opentrv/OpenTRV-TRV1.6/README.md

# OpenTRV-TRV1.6
TRV1.6 smart thermostatic radiator valve hardware and software,
evolved from TRV1.5/REV7.

A 'V0p2' type (ATmega328P) board with an alternative motor driver.
