opentrv/OpenTRV-TRV1.6/hardware/PCB/board.png

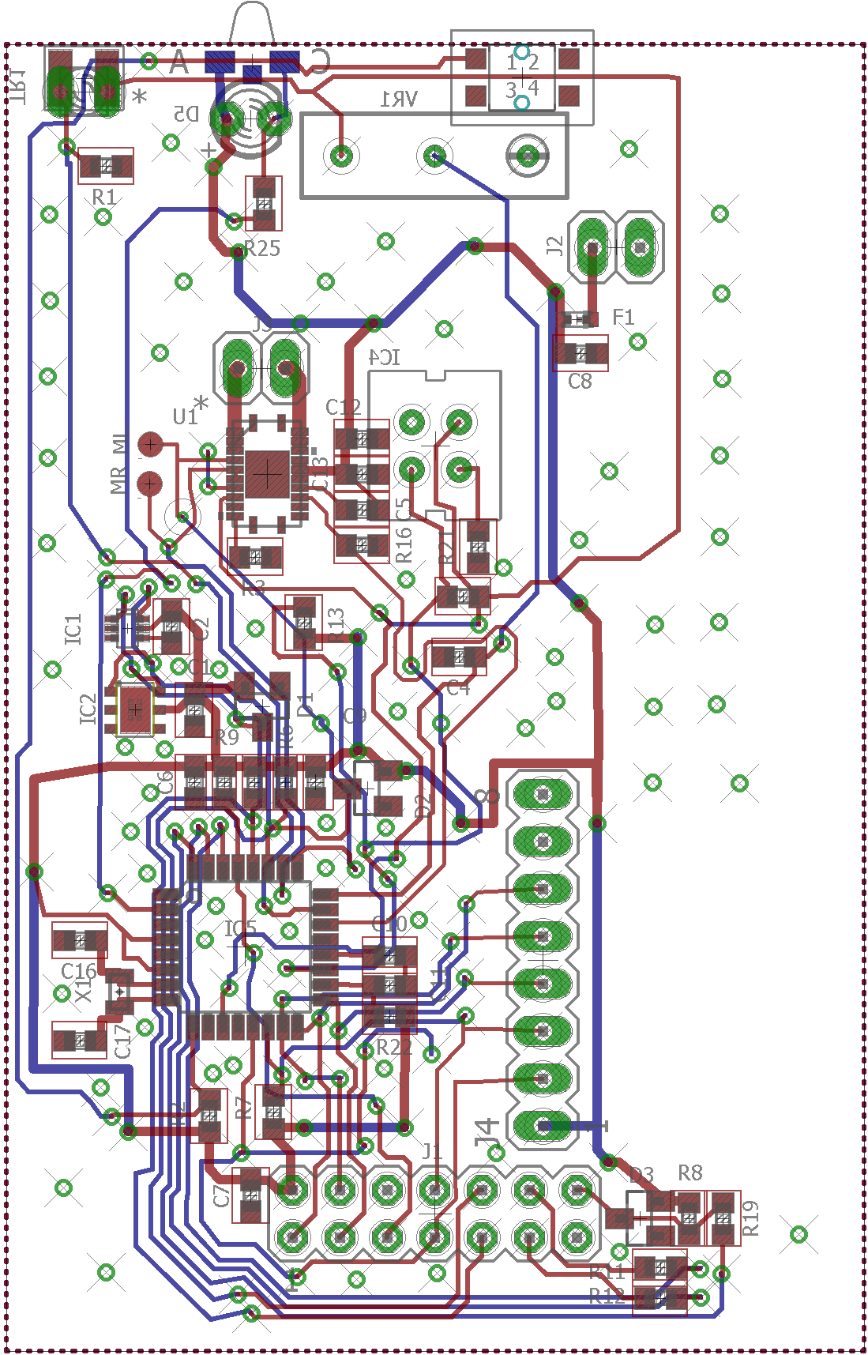
hardware/PCB/board.png
