opentrv/OpenTRV-TRV1.6/hardware/PCB/schematic.png

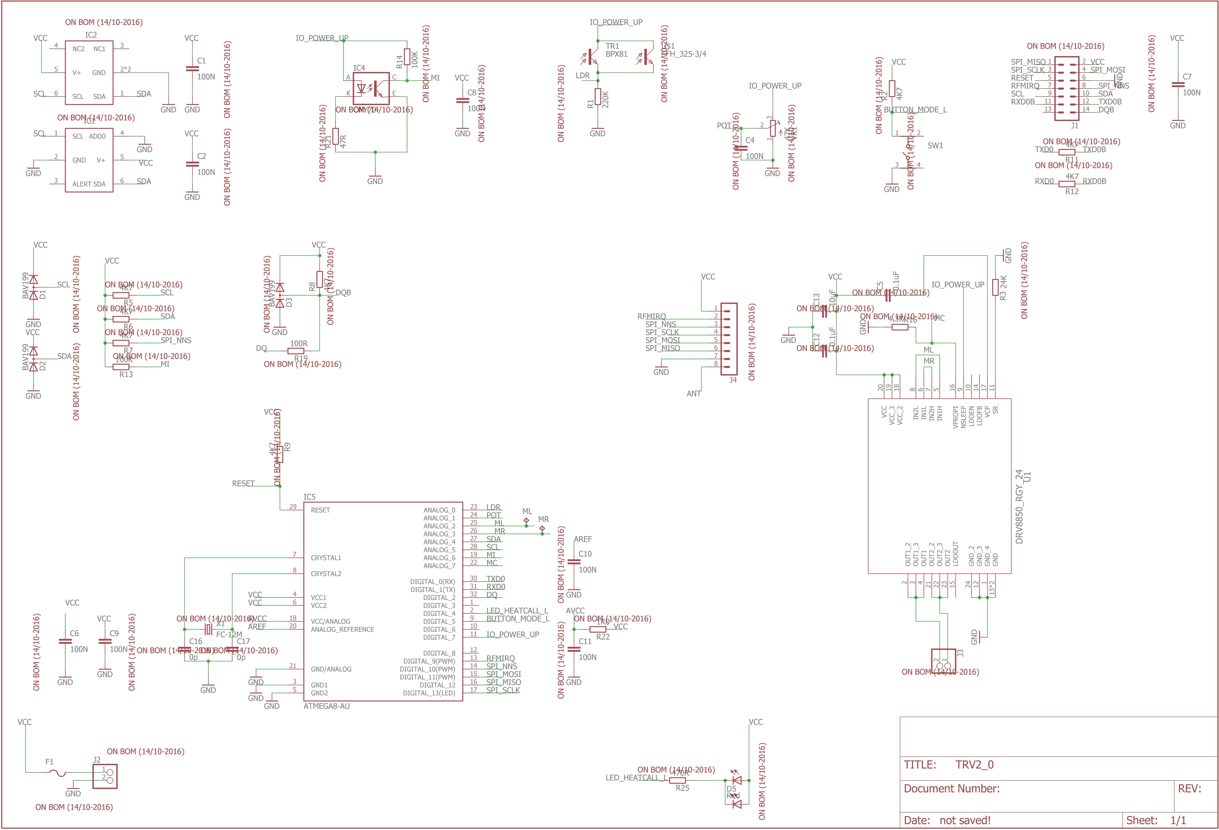
hardware/PCB/schematic.png
