opentrv/OpenTRV-TRV1.6/hardware/PCB/201610 DRAFT TRV2 BOM.ods

Sheet: Sheet3
Note | Legend | Part Type | Description | MFG | MFG Code | Supplier | Supplier Code | TYPE | Part Count | £'s Each | Total £'s
 | F1 | F.1A CHIP FUSE SMT | 1 Amp 63V | RS | CQ06PT001 | RS Components | 764-9431 | SMD | 1 | 0.08 | 0.08
C2 decoupling for TMP112, C1 decoupling for SHT21 | C1, C2, C8, C4, C7, C6, C9, C10, C11 | C0603.100N | CAP MULTILYR CHIP 100N 10% 50V X7R 0603 | AVX | 06035C104KAZ2A | RS Components | 698-3263 | SMD | 9 | 0.07 | 0.64
DO NOT FIT - In a Pack of 4000 | C16, C17 | C0603.22P | CAP MULTILYR CHIP 22P 5% 50V NPO 0603 | Phycomp | 223886715229 | RS Components | 616-9133 | SMD | 0 | 0.01 | 0.00
 | C13 | 10uF | CAP MULTILYR CHIP 10uF 5% 50V NPO 0603 | Murata | GRM188R61A106KE69D | RS Components | 846-7293 | SMD | 1 | 0.04 | 0.04
 | C12, C5 | 0.1uF | CAP MULTILYR CHIP 0.1uF 5% 50V NPO 0603 | AVX | 0603YC104JAT2A | RS Components | 391-246 | SMD | 2 | 0.00 | 0.01
IF SMD take the one below | D5 | D.3MM.RED.LED | 3mm Red LED | Kingbright | L-1154ID | RS Components | 862-2737 | LEADED | 0 | 0.05 | 0.00
 | U$2 |  | SideLED Red SMD LED | Kingbright | KPPA-3010SURCK | Farnell | 2449732 | SMD | 1 | 0.17 | 0.17
Reels of 3000 - Temporarily out of stock - Back order for despatch 09/11/2016 | D3, D1, D2 | D.BAV99 | DIODE SM_SIG EPI 200MA 70V 6NS DUAL SOT23 | FAIRCHILD SEMICONDUCTOR | BAV99 | RS Components | 545-2686 | SMD | 3 | 0.01 | 0.03
 | IC5 | IC.ATMEGA328P-AU | IC ATMEL MEGA 328P PROCESSOR 8-BIT RISC TQFP | ATMEL | ATMEGA328P-AU | RS Components | 696-3092 | SMD | 1 | 2.27 | 2.27
 | IC4 | IC.CNY70 | CNY70 Through Hole Reflective Optical Sensor Phototransistor Output | Vishay | CNY70 | RS Components | 708-5348 | LEADED | 1 | 0.61 | 0.61
DO NOT FIT - Default is TMP112 | IC2 | IC.SHT21 | Sensor Humidity & Temp 2%RH I2C | Sensirion | SHT21 | RS Components | 786-5554 | SMD | 1 | 3.32 | 3.32
 | IC1 | IC.TMP112AIDRLR | High-Accuracy Low-Power Digital Temperature Sensor | TI | TMP112AIDRLR | RS Components | 709-8868 | SMD | 0 | 1.79 | 0.00
 |  | DRV8850 | Motor driver chip
IF SMD take the one below | TR1 | O.3MM PHOTO TRANSISTOR | 3mm Photo Transistor | KingBright | L-323PC | Rapid Electronics | 58-0105 | LEADED | 0 | 0.23 | 0.00
 | U$1 |  | Sideview phototransistor | OSRAM Opto Semiconductors | SFH 325-3/4 | RS Components | 654-8003 | SMD | 1 | 0.12 | 0.12
 | VR1 | R.POT47K | 16mm Rotary pot 47K lin right angle | ISKRA | P11M47AP6L45R | JPR Electronics | 551-140 | LEADED | 1 | 0.49 | 0.49
 | R14, R13 | R0603.100K | RES THICKFLM CHIP 100K 1% 0W1 100ppm 0603 | Bourns | CR0603-FX-1003ELF | RS Components | 740-8802 | SMD | 2 | 0.01 | 0.02
 | R19 | R0603.100R | RES THICKFLM CHIP 100R 1% 0W1 100ppm 0603 | Bourns | CR0603-FX-1000ELF | RS Components | 740-8798 | SMD | 1 | 0.01 | 0.01
Reels of 5,000 | R22 | R0603.1R0 | RES THICKFLM CHIP 1R0 1% 0W1 100ppm 0603 | RS Pro | RS-0603-1R-1%-0.1W | RS Components | 716-9752 | SMD | 1 | 0.00 | 0.00
 | R1 | R0603.220K | RES THICKFLM CHIP 220K 1% 0W1 100ppm 0603 | TE Connectivity | CRG0603F220K | RS Components | 213-2581 | SMD | 1 | 0.01 | 0.01
 | R25 | R0603.470R | RES THICKFLM CHIP 470R 1% 0W1 100ppm 0603 | Vishay | CRCW0603470RFKEA | RS Components | 679-0419 | SMD | 1 | 0.01 | 0.01
 | R21 | R0603.47R | RES THICKFLM CHIP 47R 1% 0W1 100ppm 0603 | Vishay | CRCW060347R0FKEA | RS Components | 679-0437 | SMD | 1 | 0.01 | 0.01
 | R2, R11, R12, R8, R5, R6, R7, R9 | R0603.4K7 | RES THICKFLM CHIP 4K7 1% 0W1 100ppm 0603 | Bourns | CR0603-FX-4701ELF | RS Components | 740-8877 | SMD | 8 | 0.01 | 0.10
 | R16 | 4K3 | RES THICKFLM CHIP 4K3 1% 0W1 100ppm 0603 | Vishay | CRCW06034K30FKEA | RS Components | 679-0469 | SMD | 1 | 0.01 | 0.01
 | R3 | 24K | RES THICKFLM CHIP 24K 1% 0W1 100ppm 0603 | Vishay | CRCW060324K0FKEA | RS Components | 679-0046 | SMD | 1 | 0.01 | 0.01
 | SW1 | SW.TACTILE SWITCH RA | Push button SMD | Wurth Elektronik | 436333045822 | RS Components | 785-6453 | SMD | 1 | 0.35 | 0.35
 | X1 | X.32.7689KHZ SMT 2 PIN | QTC3 Series 1.5x3.2 SMD Tuning Fork 12.5pf | QANTEK | QTC332.76812B2R | RS Components | 814-9352 | SMD | 1 | 0.45 | 0.45
 | J1 | J.14WAY HEADER RA | .54 mm Pitch 14 Way 2 Row Right Angle PCB Header | Wurth Elektronik | 61301421021 | RS Components | 828-1715 | LEADED | 1 | 0.72 | 0.72
 | J2, J3 | HEADER 2 WAY | 2 pin header. 0.254mm | Molex | 22-23-2021 | RS Components | 679-5583 | LEADED | 2 | 0.06 | 0.12
For optional RFM or other radio module | J4 | HEADER 8 WAY | 8 pin header. 0.254mm |  |  |  |  | LEADED | 0 |  | 0.00
 |  |  |  |  |  |  |  |  |  |  | 10

Sheet: BOM
Note | Legend | Part Type | Description | MFG | MFG Code | Supplier | Supplier Code | TYPE | Part Count | £'s Each | Total £'s
C19, C20, C21, C22 skipped as it was motor driver related | C19, C20, C21, C22 | C.100UF/6.3V | 100000 nF ±20 % 6.3 V X5R Dielectric | Samsung Electro-Mechanics | CL31A107MQHNNNE | RS Components | 766-1078 | LEADED | 4 | 227 | 908
 | C18 | C.ATANT 10U 6V | CAP TANT 10µ 20% 6V -55/+125C SM | EPCOS |  | RS Components | 538-2363 | SMD | 1 | 172 | 1,721
C13 skipped as it was motor driver related | C1, C2, C3, C4, C8, C9, C10, C11, C12, C5, C6, C7 | C0603.100N | CAP MULTILYR CHIP 100N 10% 50V X7R 0603 | Murata | GRM188R71H104KA93D | RS Components | 545-9895 | SMD | 15 | 0,07 | 1,05
NOT FOUND on schematic |  | C0603.10N | CAP MULTILYR CHIP 10N 10% 50V X7R 0603 | Phycomp | CC0603KRX7R9BB103 | JPR Electronics | 133-846 | SMD | 4 | 247 | 988
DO NOT FIT | C16, C17 | C0603.22P | CAP MULTILYR CHIP 22P 5% 50V NPO 0603 | Phycomp | 223886715229 | RS Components | 616-9133 | SMD | 2 | 4 | 8
REMOVED | D4 | D.3MM.GREEN.LED | 3mm GREEN LED |  |  | Rapid Electronics | 55-1670 | LEADED | 1 | 0,28 | 0,28
 | D5 | D.3MM.RED.LED | 3mm Red LED |  |  | Rapid Electronics | 72-8942 | LEADED | 1 | 0,1 | 0,1
 | D3, D1, D2 | D.BAV99 | DIODE SM_SIG EPI 200MA 70V 6NS DUAL SOT23 | FAIRCHILD SEMICONDUCTOR | BAV99 | RS Components Contract | 545-2686 | SMD | 3 | 225 | 675
D6a, D6b skipped as it was motor driver related | D6a, D6b | D.SDA004 | DATA BUS TRANSIENT SUPPRESSOR | DiodesZetex | SDA004-7 | RS Components | 751-4938 | SMD | 1 | 0,4 | 0,4
 | F1 | F.1A CHIP FUSE SMT | 1 Amp 63V | RS | CQ06PT001 | RS Components | 764-9431 | SMD | 1 | 154 | 154
NOT FOUND on schematic |  | HEADER 1 WAY | 1 pin header. 0.254mm |  |  | SIL | 0 | LEADED | 5 | 1 | 5
 | J2, J4 | HEADER 2 WAY | 2 pin header. 0.254mm | Harwin |  | JPR Electronics | 710-622 | LEADED | 2 | 23 | 46
 | IC3 | IC.APDS-9300 | Ambient light sensor digital I2C SMT | Avago Technologies | APDS-9300-020 | RS Components | 691-0470 | SMD | 1 | 0,64 | 0,64
 | IC5 | IC.ATMEGA328P-AU | IC ATMEL MEGA 328P PROCESSOR 8-BIT RISC TQFP | ATMEL | ATMEGA328P-AU | RS Components | 696-3092 | SMD | 1 | 2,28 | 22,801
 | IC4 | IC.CNY70 | CNY70 Through Hole Reflective Optical Sensor Phototransistor Output | Vishay | CNY70 | RS Components | 708-5348 | SMD | 1 | 566 | 5,661
 | IC2 | IC.SHT21 | Sensor Humidity & Temp 2%RH I2C | Sensirion | SHT21 | RS Components | 786-5554 | SMD | 1 | 2,91 | 2,91
 | IC1 | IC.TMP112AIDRLR | High-Accuracy Low-Power Digital Temperature Sensor | TI | TMP112AIDRLR | RS Components | 709-8868 | SMD | 1 | 1,7 | 1,7
IC6 skipped as it was motor driver related | IC6 | IC.TS1003IG5T | Operational Amplifier Precision 4 kHz R-R 0.8 - 5.5 V | Touchstone Semiconductor | TS1003IG5T | RS Components | 787-8080 | SMD | 1 | 551 | 551
 | J1 | J.14WAY HEADER RA | .54 mm Pitch 14 Way 2 Row Right Angle PCB Header | Samtec | TSW-107-08-L-D-RA | RS Components | 767-0968 | LEADED | 1 | 1,25 | 1,25
L1 skipped as it was motor driver related | L1 | L..1.2UH SMD | 1.2uH inductor | Wurth Electronic | 74438313012 | RS Components | 792-2711 | SMD | 3 | 1,08 | 3,24
 | MD1 | MD.RFM23B | RFM23B ISM TRANSCEIVER MODULE | HOPERF | RFM23B-S | RS Components | 762-0103 | SMD | 1 | 5,8 | 5,8
 | - | MTFLR-001-SSL | PCB FR4 2 Layer PTH |  |  | ONE Way | MTFLR-001-SSL | PCB | 1 | 1 | 1
 | TR1 | O.3MM PHOTO TRANSISTOR | 3mm Photo Transistor | KingBright | L-323PC | Rapid Electronics | 58-0105 | LEADED | 1 | 0,12 | 0,12
 | - | OTRVRV-002-SIL | PCB FR4 2 Layer PTH |  |  | ONE Way | OTRVRV-002-SIL | PCB | 1 | 0,5 | 0,5
 | VR1 | R.POT47K | 16mm Rotary pot 47K lin right angle | ISKRA | P11M47AP6L45R | JPR Electronics | 551-140 | LEADED | 1 | 0,49 | 0,49
R15, R16, R17 skipped as it was motor driver related | R14, R13 | R0603.100K | RES THICKFLM CHIP 100K 1% 0W063 50V 100ppm 0603 | WELWYN | WCR0603104 1% 100ppm | JPR Electronics | 406-705 | SMD | 6 | 15 | 0,09
R20 skipped as it was motor driver related | R19 | R0603.100R | RES THICKFLM CHIP 100R 1% 0W063 50V 100ppm 0603 | WELWYN | WCR0603101 1% 100ppm | JPR Electronics | 406-634 | SMD | 2 | 25 | 5
R34, R35 skipped as it was motor driver related | R34, R35 | R0603.10K | RES THICKFLM CHIP 10K 1% 0W063 50V 100ppm 0603 | WELWYN | WCR0603103 1% 100ppm | JPR Electronics | 406-682 | SMD | 2 | 15 | 0,03
R38, R37 skipped as it was motor driver related | R38, R37 | R0603.15K | RES THICKFLM CHIP 15K 1% 0W063 50V 100ppm 0603 | WELWYN | WCR0603153 1% 100ppm | JPR Electronics | 406-686 | SMD | 2 | 15 | 3
 | R22, R23 | R0603.1R0 | RES THICKFLM CHIP 1R0 1% 0W063 50V 100ppm 0603 | WELWYN | 1% 100ppm | RS Components | 504-8978 | SMD | 2 | 211 | 43
 | R1 | R0603.220K | RES THICKFLM CHIP 220K 1% 0W063 50V 100ppm 0603 | WELWYN | WCR0603224 1% 100ppm | JPR Electronics | 406-712 | SMD | 1 | 16 | 16
R39 skipped as it was motor driver related | R39 | R0603.330K | RES THICKFLM CHIP 330K 1% 0W063 50V 100ppm 0603 | RS | RS-0603-330k-1%-0.1W | JPR Electronics | 406-716 | SMD | 1 | 16 | 16
R28, R29 skipped as it was motor driver related | R28, R29 | R0603.330R | RES THICKFLM CHIP 330R 1% 0W063 50V 100ppm 0603 | RS |  | RS Components | 617-6434 | SMD | 2 | 8 | 16
R40 skipped as it was motor driver related | R40 | R0603.3M3 | RES THICKFLM CHIP 3M3 1% 0W063 50V 100ppm 0603 | Phycomp |  | RS Components | 504-6540 | SMD | 1 | 22 | 22
R24 Removed. R26, R27 skipped as it was motor driver related | R24, R25 | R0603.470R | RES THICKFLM CHIP 470R 1% 0W063 50V 100ppm 0603 | WELWYN | WCR0603471 1% 100ppm | JPR Electronics | 406-650 | SMD | 4 | 25 | 0,01
 | R21 | R0603.47R | RES THICKFLM CHIP 47R 1% 0W063 50V 100ppm 0603 | WELWYN | WCR0603470 1% 100ppm | RS Components | 617-6658 | SMD | 1 | 8 | 8
R3, R4 Removed | R8, R10, R5, R6, R7, R2, R3, R4, R11, R12, R9 | R0603.4K7 | RES THICKFLM CHIP 4K7 1% 0W063 50V 100ppm 0603 | WELWYN | WCR0603472 1% 100ppm | JPR Electronics | 406-674 | SMD | 11 | 15 | 1,651
R36 skipped as it was motor driver related | R36 | R1206.0R1 | RES THICKFLM CHIP 0R33 1% 0W25 1206 | WELWYN |  | Farnell | 1795287 | SMD | 1 | 68 | 68
R32, R33 skipped as it was motor driver related | R32, R33 | R1206.100R | RES THICKFLM CHIP 100R 1% 0W25 1206 | RS |  | RS Components | 617-6327 | SMD | 2 | 12 | 24
R30, R31 skipped as it was motor driver related | R30, R31 | R1206.470R | RES THICKFLM CHIP 470R 1% 0W25 1206 | WELWYN | WCR1206470R | RS Components | 617-5447 | SMD | 2 | 12 | 24
SW2, SW3 Removed | SW1, SW2, SW3 | SW.TACTILE SWITCH RA | Push button SMD | Wurth Elektronik | 436331045822 | RS Components | 785-6459 | LEADED | 3 | 0,33 | 0,99
TR8, TR9 skipped as it was motor driver related | TR8, TR9 | TR.ZXTN23015 | ZXTN23015CFHTA Bipolar Transistor NPN 6 A 15 V HFE150 235 MHz | DiodesZetex | ZXTN23015CFHTA | RS Components | 751-5423 | SMD | 2 | 0,56 | 1,12
TR2, TR3, TR4, TR5, TR6, TR7 skipped as it was motor driver related | TR2, TR3, TR4, TR5, TR6, TR7 | TRP.ZXTP23015 | ZXTP23015CFHTA Bipolar Transistor PNP -6 A -15 V HFE:140 270Mhz | DiodesZetex | ZXTP23015CFHTA | RS Components | 751-5451 | SMD | 6 | 551 | 3,306
 | X1 | X.32.7689KHZ SMT 2 PIN | QTC3 Series 1.5x3.2 SMD Tuning Fork 12.5pf | QANTEK | QTC332.76812B2R | RS Components | 814-9352 | SMD | 1 | 434 | 434
 |  |  |  |  |  |  |  |  |  |  | 306,394

Sheet: Pick&Place
Placed | Designator | Footprint | Mid X | Mid Y | Ref X | Ref Y | Pad X | Pad Y | Layer | Rotation | Comment
* | F1 | CQ06PT | 1104mil | 2176mil | 1104mil | 2176mil | 1076.047mil | 2176mil | T | 0 | F.1A CHIP FUSE SMT
 | D6 | SOT363 | 597.402mil | 2166.409mil | 560mil | 2192mil | 560mil | 2192mil | T | 360 | D.SDA004
* | MD1 | RFM23B-S1 | 1253.039mil | 747.591mil | 1568mil | 472mil | 1568mil | 472mil | T | 180 | MD.RFM23B
* | J1 | IDC14-HEADER | 804mil | 290mil | 504mil | 240mil | 504mil | 240mil | T | 90 | J.14WAY HEADER RA
* | R9 | SM0603 | 360mil | 1200mil | 360mil | 1200mil | 360mil | 1167.5mil | T | 180 | R0603.4K7
* | R7 | SM0603 | 464mil | 504mil | 464mil | 504mil | 464mil | 471.5mil | T | 180 | R0603.4K7
* | R6 | SM0603 | 488mil | 1200mil | 488mil | 1200mil | 488mil | 1232.5mil | T | 360 | R0603.4K7
* | R23 | SM0603 | 1224mil | 1112mil | 1224mil | 1112mil | 1191.5mil | 1112mil | T | 90 | R0603.1R0
* | R22 | SM0603 | 709.221mil | 706.74mil | 709.221mil | 706.74mil | 676.721mil | 706.74mil | T | 90 | R0603.1R0
* | R5 | SM0603 | 424mil | 1200mil | 424mil | 1200mil | 424mil | 1232.5mil | T | 360 | R0603.4K7
* | R12 | SM0603 | 1280mil | 112mil | 1280mil | 112mil | 1312.5mil | 112mil | T | 270 | R0603.4K7
* | IC5 | Quad32 | 404.079mil | 852.323mil | 228.882mil | 962.559mil | 228.882mil | 962.559mil | T | 360 | IC.ATMEGA328P-AU
* | C1 | SM0603 | 296mil | 1352mil | 296mil | 1352mil | 296mil | 1384.5mil | T | 360 | C0603.100N
* | C3 | SM0603 | 440mil | 2552mil | 440mil | 2552mil | 472.5mil | 2552mil | T | 270 | C0603.100N
* | C2 | SM0603 | 248mil | 1528mil | 248mil | 1528mil | 248mil | 1560.5mil | T | 360 | C0603.100N
* | C4 | SM0603 | 856mil | 1464mil | 856mil | 1464mil | 888.5mil | 1464mil | T | 270 | C0603.100N
* | C5 | SM0603 | 920mil | 1152mil | 920mil | 1152mil | 920mil | 1119.5mil | T | 180 | C0603.100N
* | C8 | SM0603 | 1112mil | 2104mil | 1112mil | 2104mil | 1079.5mil | 2104mil | T | 90 | C0603.100N
* | C9 | SM0603 | 552mil | 1200mil | 552mil | 1200mil | 552mil | 1232.5mil | T | 360 | C0603.100N
* | C10 | SM0603 | 709.221mil | 834.74mil | 709.221mil | 834.74mil | 741.721mil | 834.74mil | T | 270 | C0603.100N
* | C11 | SM0603 | 709.221mil | 770.74mil | 709.221mil | 770.74mil | 676.721mil | 770.74mil | T | 90 | C0603.100N
* | C7 | SM0603 | 416mil | 328mil | 416mil | 328mil | 416mil | 360.5mil | T | 360 | C0603.100N
* | C6 | SM0603 | 296mil | 1200mil | 296mil | 1200mil | 296mil | 1232.5mil | T | 360 | C0603.100N
* | C12 | SM0603 | 1648mil | 752mil | 1648mil | 752mil | 1648mil | 784.5mil | T | 360 | C0603.100N
 | C13 | SM0603 | 1007.488mil | 1709.441mil | 1007.488mil | 1709.441mil | 974.988mil | 1709.441mil | T | 90 | C0603.100N
 | C14 | SM0603 | 456mil | 1792mil | 456mil | 1792mil | 488.5mil | 1792mil | T | 270 | C0603.100N
 | C15 | SM0603 | 608mil | 1688mil | 608mil | 1688mil | 608mil | 1655.5mil | T | 180 | C0603.100N
* | C16 | SM0603 | 103.599mil | 880.378mil | 103.599mil | 880.378mil | 103.599mil | 847.878mil | T | 180 | C0603.22P
* | C17 | SM0603 | 152mil | 624mil | 152mil | 624mil | 119.5mil | 624mil | T | 90 | C0603.22P
* | C18 | TANTA | 1391.5mil | 1112mil | 1344mil | 1112mil | 1344mil | 1112mil | T | 360 | C.ATANT 10U 6V
 | C19 | SM1206 | 990.85mil | 2331.528mil | 990.85mil | 2331.528mil | 990.85mil | 2276.528mil | T | 180 | C.100UF/6.3V
 | C20 | SM1206 | 1161.48mil | 2007.968mil | 1161.48mil | 2007.968mil | 1106.48mil | 2007.968mil | T | 90 | C.100UF/6.3V
 | C21 | SM1206 | 1161.48mil | 1903.968mil | 1161.48mil | 1903.968mil | 1106.48mil | 1903.968mil | T | 90 | C.100UF/6.3V
 | C22 | SM1206 | 1161.48mil | 1799.968mil | 1161.48mil | 1799.968mil | 1106.48mil | 1799.968mil | T | 90 | C.100UF/6.3V
* | D1 | SOT23 | 440mil | 1360mil | 440mil | 1360mil | 477.5mil | 1400mil | T | 270 | D.BAV99
* | D2 | SOT23 | 661.221mil | 1186.74mil | 661.221mil | 1186.74mil | 701.221mil | 1149.24mil | T | 180 | D.BAV99
* | D3 | SOT23 | 1224mil | 280mil | 1224mil | 280mil | 1264mil | 242.5mil | T | 180 | D.BAV99
* | IC1 | SOT563(6PIN) | 154.575mil | 1524.315mil | 128mil | 1544mil | 128mil | 1544mil | T | 360 | IC.TMP112AIDRLR
* | R1 | SM0603 | 160mil | 2512mil | 160mil | 2512mil | 192.5mil | 2512mil | T | 270 | R0603.220K
 | R15 | SM0603 | 177mil | 1941.945mil | 177mil | 1941.945mil | 144.5mil | 1941.945mil | T | 90 | R0603.100K
 | R16 | SM0603 | 864mil | 2048mil | 864mil | 2048mil | 831.5mil | 2048mil | T | 90 | R0603.100K
 | R17 | SM0603 | 224mil | 2320mil | 224mil | 2320mil | 191.5mil | 2320mil | T | 90 | R0603.100K
 | R18 | SM0603 | 176mil | 2080mil | 176mil | 2080mil | 176mil | 2112.5mil | T | 360 | R0603.100K
* | R8 | SM0603 | 1328mil | 280mil | 1328mil | 280mil | 1328mil | 247.5mil | T | 180 | R0603.4K7
* | R2 | SM0603 | 328mil | 496mil | 328mil | 496mil | 328mil | 528.5mil | T | 360 | R0603.4K7
* | R3 | SM0603 | 352mil | 328mil | 352mil | 328mil | 352mil | 295.5mil | T | 180 | R0603.4K7
* | R4 | SM0603 | 144mil | 1200mil | 144mil | 1200mil | 144mil | 1167.5mil | T | 180 | R0603.4K7
* | R10 | SM0603 | 400mil | 504mil | 400mil | 504mil | 400mil | 536.5mil | T | 360 | R0603.4K7
* | R11 | SM0603 | 1280mil | 176mil | 1280mil | 176mil | 1312.5mil | 176mil | T | 270 | R0603.4K7
 | R20 | SM0603 | 592mil | 1536mil | 592mil | 1536mil | 592mil | 1568.5mil | T | 360 | R0603.100R
* | R13 | SM0603 | 528mil | 1536mil | 528mil | 1536mil | 528mil | 1503.5mil | T | 180 | R0603.100K
* | R14 | SM0603 | 864mil | 1592mil | 864mil | 1592mil | 831.5mil | 1592mil | T | 90 | R0603.100K
 | R34 | SM0603 | 688mil | 2000mil | 688mil | 2000mil | 720.5mil | 2000mil | T | 270 | R0603.10K
 | R35 | SM0603 | 328mil | 2128mil | 328mil | 2128mil | 328mil | 2095.5mil | T | 180 | R0603.10K
* | R19 | SM0603 | 1400mil | 280mil | 1400mil | 280mil | 1400mil | 247.5mil | T | 180 | R0603.100R
* | R21 | SM0603 | 896mil | 1696mil | 896mil | 1696mil | 896mil | 1663.5mil | T | 180 | R0603.47R
* | R24 | SM0603 | 1344mil | 2504mil | 1344mil | 2504mil | 1344mil | 2471.5mil | T | 180 | R0603.470R
* | R25 | SM0603 | 544mil | 2520mil | 544mil | 2520mil | 544mil | 2487.5mil | T | 180 | R0603.470R
 | R26 | SM0603 | 145mil | 1837.945mil | 145mil | 1837.945mil | 145mil | 1870.445mil | T | 360 | R0603.470R
 | R27 | SM0603 | 240mil | 2080mil | 240mil | 2080mil | 240mil | 2047.5mil | T | 180 | R0603.470R
 | R28 | SM0603 | 720mil | 1728mil | 720mil | 1728mil | 720mil | 1695.5mil | T | 180 | R0603.330R
 | R29 | SM0603 | 104mil | 2080mil | 104mil | 2080mil | 104mil | 2112.5mil | T | 360 | R0603.330R
 | R32 | SM1206 | 848mil | 2184mil | 848mil | 2184mil | 848mil | 2129mil | T | 180 | R1206.100R
 | R33 | SM1206 | 200mil | 2424mil | 200mil | 2424mil | 255mil | 2424mil | T | 270 | R1206.100R
 | R30 | SM1206 | 520mil | 2008mil | 520mil | 2008mil | 465mil | 2008mil | T | 90 | R1206.470R
 | R31 | SM1206 | 392mil | 2248mil | 392mil | 2248mil | 447mil | 2248mil | T | 270 | R1206.470R
 | R36 | SM1206 | 520mil | 1904mil | 520mil | 1904mil | 465mil | 1904mil | T | 90 | R1206.0R047
 | R37 | SM0603 | 584mil | 1792mil | 584mil | 1792mil | 616.5mil | 1792mil | T | 270 | R0603.15K
 | R38 | SM0603 | 392mil | 1688mil | 392mil | 1688mil | 392mil | 1720.5mil | T | 360 | R0603.15K
 | R39 | SM0603 | 432mil | 1568mil | 432mil | 1568mil | 399.5mil | 1568mil | T | 90 | R0603.330K
 | R40 | SM0603 | 432mil | 1504mil | 432mil | 1504mil | 399.5mil | 1504mil | T | 90 | R0603.3M3
* | SW1 | SWWSTUS | 1088mil | 2686.535mil | 977.764mil | 2720mil | 1198.236mil | 2653.071mil | T | 360 | SW.TACTILE SWITCH RA
 | TR2 | SOT23 | 249mil | 1837.945mil | 249mil | 1837.945mil | 209mil | 1875.445mil | T | 360 | TRP.ZXTP23015
 | TR3 | SOT23 | 688mil | 1896mil | 688mil | 1896mil | 728mil | 1858.5mil | T | 180 | TRP.ZXTP23015
 | TR4 | SOT23 | 784mil | 2352mil | 784mil | 2352mil | 824mil | 2314.5mil | T | 180 | TRP.ZXTP23015
 | TR5 | SOT23 | 376mil | 2368mil | 376mil | 2368mil | 336mil | 2405.5mil | T | 360 | TRP.ZXTP23015
 | TR6 | SOT23 | 184mil | 2216mil | 184mil | 2216mil | 144mil | 2253.5mil | T | 360 | TRP.ZXTP23015
 | TR7 | SOT23 | 344mil | 1984mil | 344mil | 1984mil | 304mil | 2021.5mil | T | 360 | TRP.ZXTP23015
 | TR9 | SOT23 | 432mil | 2128mil | 432mil | 2128mil | 392mil | 2165.5mil | T | 360 | TR.ZXTN23015
 | TR8 | SOT23 | 728mil | 2104mil | 728mil | 2104mil | 690.5mil | 2064mil | T | 90 | TR.ZXTN23015
 | FD1 | FDMARKS | 1664mil | 248mil | 1664mil | 248mil | 1664mil | 248mil | T | 0 | FD.FDMARK
 | FD2 | FDMARKS | 224mil | 240mil | 224mil | 240mil | 224mil | 240mil | T | 0 | FD.FDMARK
 | FD3 | FDMARKS | 104mil | 2320mil | 104mil | 2320mil | 104mil | 2320mil | T | 0 | FD.FDMARK
 | FD4 | FDMARKS | 1644.11mil | 2602.008mil | 1644.11mil | 2602.008mil | 1644.11mil | 2602.008mil | T | 0 | FD.FDMARK
 | PCB1 | BLANK | -2000mil | -3000mil | 1896mil | -80mil | -2000mil | -3000mil | T | 0 | OTRVRV-002-SIL
* | IC3 | APDS-9301 | 329.866mil | 2663.37mil | 384mil | 2624mil | 384mil | 2702.74mil | T | 180 | IC.APDS-9300
* | J2 | HEADER_2 | 1186.787mil | 2328mil | 1136mil | 2328mil | 1136.787mil | 2328mil | T | 0 | HEADER 2 WAY
* | J4 | HEADER_2 | 610.787mil | 2328mil | 560mil | 2328mil | 560.787mil | 2328mil | T | 0 | HEADER 2 WAY
* | SW2 | SWWSTUS | 209.764mil | 97.465mil | 320mil | 64mil | 99.528mil | 130.929mil | T | 180 | SW.TACTILE SWITCH RA
* | SW3 | SWWSTUS | 1601.764mil | 97.465mil | 1712mil | 64mil | 1491.528mil | 130.929mil | T | 180 | SW.TACTILE SWITCH RA
* | IC2 | DFN6 | 171.055mil | 1352.63mil | 112mil | 1392mil | 112mil | 1392mil | T | 0 | IC.SHT21
 | IC6 | SOT-23(5PIN) | 498.5mil | 1678mil | 536mil | 1728mil | 536mil | 1728mil | T | 180 | IC.TS1003IG5T
* | X1 | QTC3 | 120mil | 736mil | 120mil | 736mil | 120mil | 785.213mil | T | 270 | X.32.7689KHZ SMT 2 PIN
 | L1 | CL1.8x1.8 | 990.85mil | 2120mil | 990.85mil | 2120mil | 990.85mil | 2141.653mil | T | 270 | L..1.2UH SMD
* | IC4 | CNY70 | 904.882mil | 1910mil | 960mil | 1960mil | 960mil | 1960mil | B | 180 | IC.CNY70
* | VR1 | P11M | 904mil | 2520.5mil | 904mil | 2520mil | 707.15mil | 2521mil | B | 360 | R.POT47K
* | D5 | 3MM_LED | 502mil | 2656mil | 452mil | 2656mil | 452mil | 2656mil | B | 360 | D.3MM.RED.LED
* | D4 | 3MM_LED | 1318mil | 2656mil | 1268mil | 2656mil | 1268mil | 2656mil | B | 360 | D.3MM.GREEN.LED
* | TR1 | 3MM_LED | 163.281mil | 2656mil | 113.281mil | 2656mil | 113.281mil | 2656mil | B | 360 | O.3MM PHOTO TRANSISTOR
