opentrv/OpenTRV-TRV1.6/hardware/PCB/TRV2_0.brd

## EAGLE design hardware/PCB/TRV2_0.brd (2016-10-20)

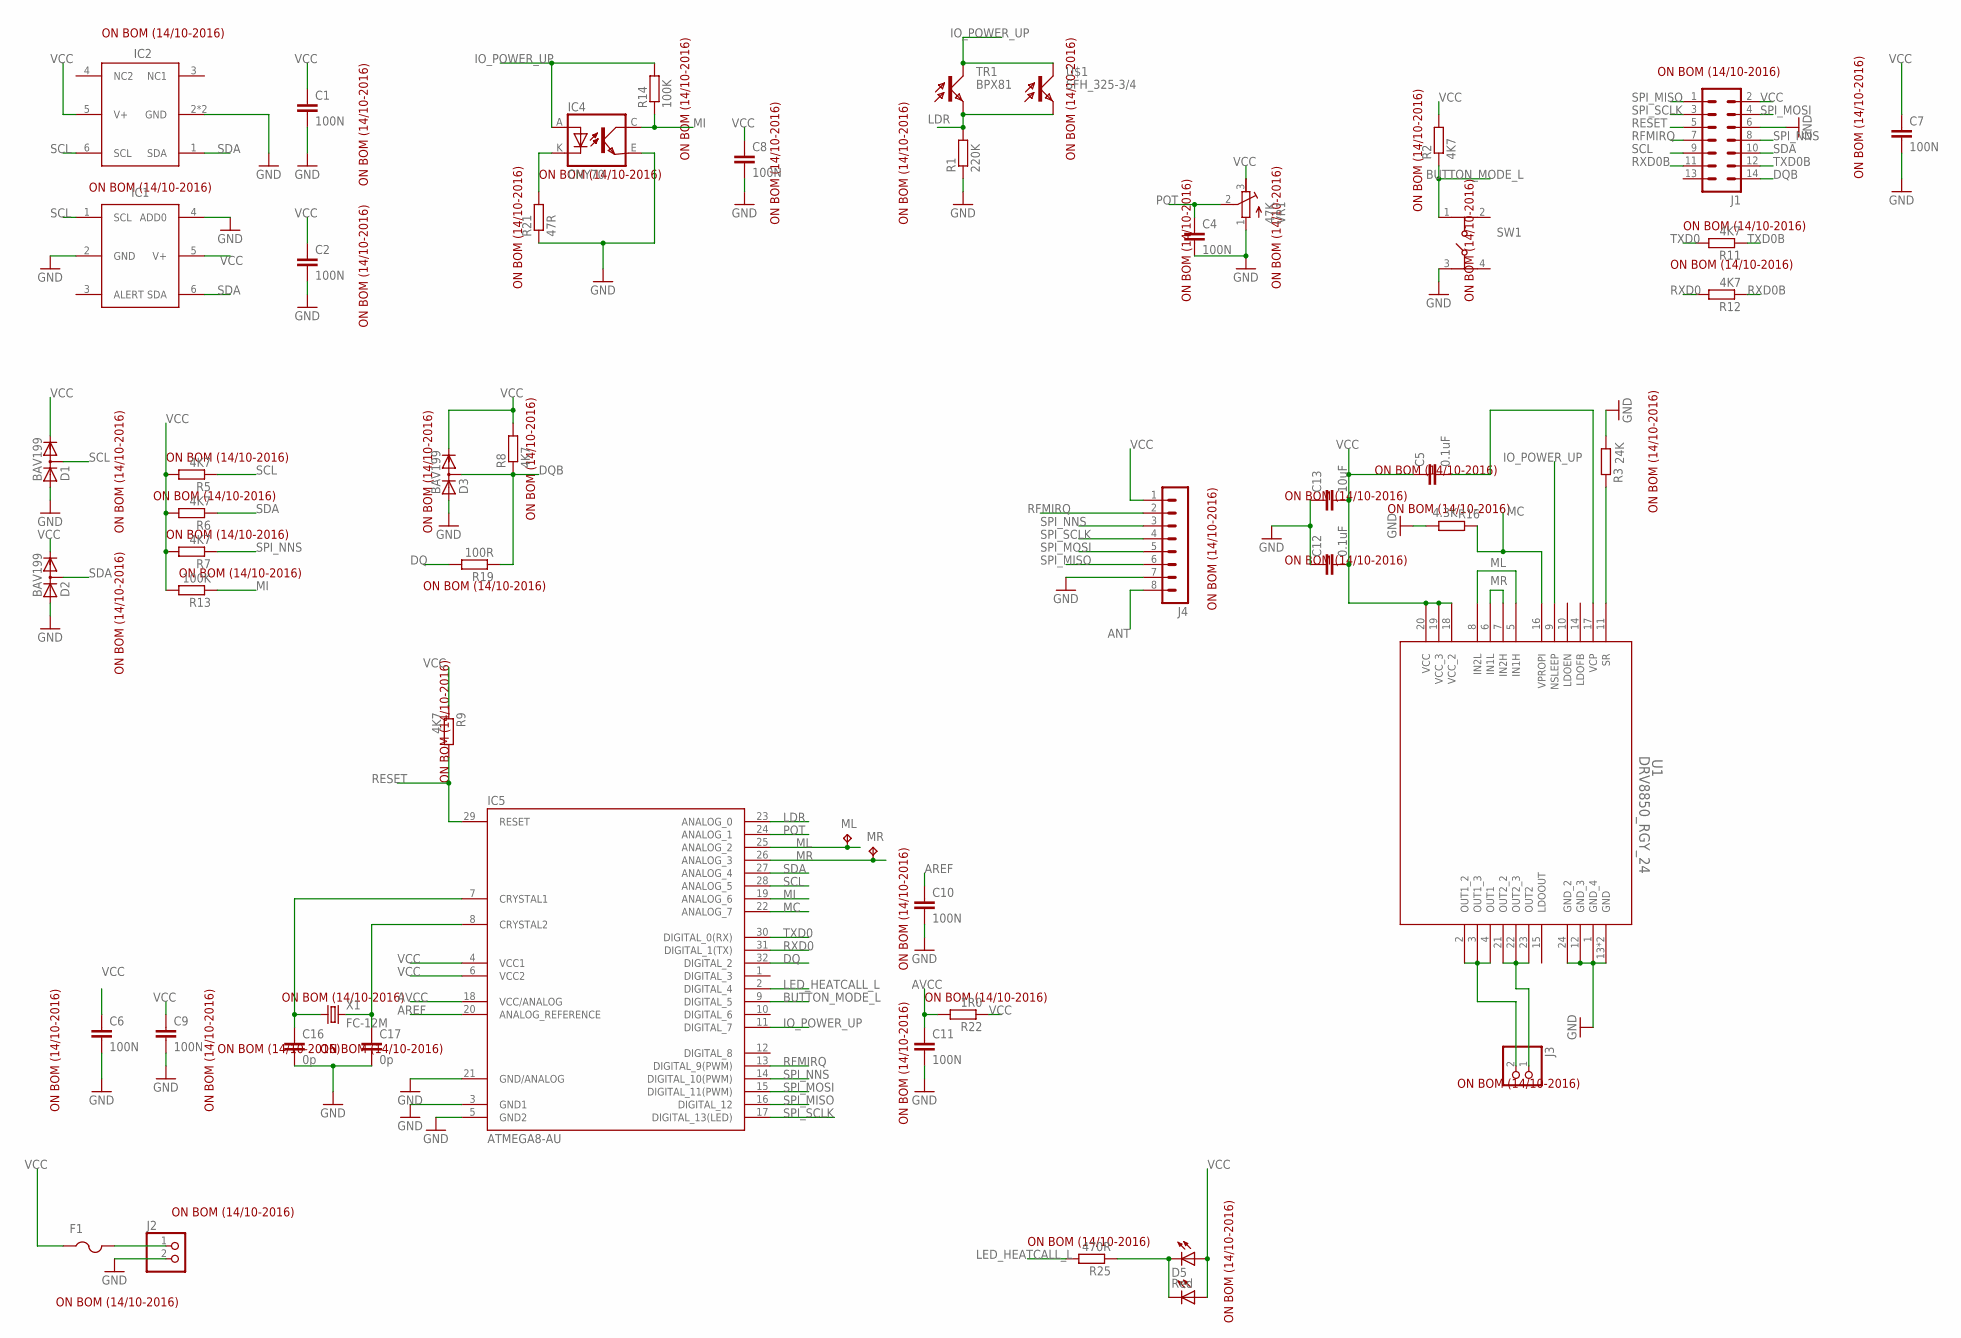
[picture p3: schematic TRV2_0.sch]

Parts:
C1, C2, C4, C6, C7, C8, C9, C10, C11: 100N; C0603
C5, C12: 0.1uF; C0603
C13: 10uF; C0603
C16, C17: 0p; C0603
D1, D2, D3: BAV199; SOT23
D5: Red; LED3MM
F1: PTCFUSE-0603; CHIPLED-0603-TTW
IC1: TMP112
IC2: IC2; SHT21
IC4: CNY70; 4
IC5: ATMEGA8-AU; TQFP32-08
J1: MA07-2
J2, J3: PINHD-1X2; 1X02
J4: MA08-1
ML: TPB1,27; B1,27
MR: TPB1,27; B1,27
R1: 220K; R0603
R2, R5, R6, R7, R8, R9, R11, R12: 4K7; R0603
R3: 24K; R0603
R13, R14: 100K; R0603
R16: 4.3K; R0603
R19: 100R; R0603
R21: 47R; R0603
R22: 1R0; R0603
R25: 470R; R0603
SW1: 434331013822
TR1: BPX81
U1: DRV8850_RGY_24; RGY_24
U$1: SFH_325-3/4
U$2: KINGBRIGHTSIDELED
VR1: 47K; RTRIM3296W
X1: FC-12M

Connections:
ANT: J4.8
AREF: C10.1, IC5.20 (ANALOG_REFERENCE)
AVCC: C11.1, IC5.18 (VCC/ANALOG), R22.2
BUTTON_MODE_L: IC5.9 (DIGITAL_5), R2.1, SW1.1
DQ: IC5.32 (DIGITAL_2), R19.2
DQB: D3.3 (AC), J1.14, R8.1, R19.1
GND: C1.2, C2.2, C4.2, C6.2, C7.2, C8.2, C9.2, C10.2, C11.2, C12.1, C13.1, C16.2, C17.2, D1.1 (A), D2.1 (A), D3.1 (A), IC1.2 (GND), IC1.4 (ADD0), IC2.2 (GND), IC2.P$1 (GND), IC4.E (EMI), IC5.3 (GND1), IC5.5 (GND2), IC5.21 (GND/ANALOG), J1.6, J2.2, J4.7, R1.1, R3.1, R16.1, R21.1, SW1.3, U1.1 (GND_4), U1.12 (GND_3), U1.13 (GND), U1.24 (GND_2), U1.25 (GND), VR1.1 (A)
IO_POWER_UP: IC4.A, IC5.11 (DIGITAL_7), R14.2, TR1.C, U1.9 (NSLEEP), U$1.P$2 (C)
LDR: IC5.23 (ANALOG_0), R1.2, TR1.E, U$1.P$1 (E)
LED_HEATCALL_L: IC5.2 (DIGITAL_4), R25.2
MC: IC5.22 (ANALOG_7), R16.2, U1.16 (VPROPI)
MI: IC4.C (COL), IC5.19 (ANALOG_6), R13.1, R14.1
ML: IC5.25 (ANALOG_2), ML.TP, U1.5 (IN1H), U1.8 (IN2L)
MR: IC5.26 (ANALOG_3), MR.TP, U1.6 (IN1L), U1.7 (IN2H)
unnamed: IC4.K (C), R21.2
unnamed: J3.2, U1.2 (OUT1_2), U1.3 (OUT1_3), U1.4 (OUT1)
unnamed: C16.1, IC5.7 (CRYSTAL1), X1.1
unnamed: C17.1, IC5.8 (CRYSTAL2), X1.2
unnamed: D5.K (C), R25.1, U$2.C
unnamed: F1.C (2), J2.1
unnamed: J3.1, U1.21 (OUT2_2), U1.22 (OUT2_3), U1.23 (OUT2)
unnamed: R3.2, U1.11 (SR)
unnamed: C5.2, U1.17 (VCP)
POT: C4.1, IC5.24 (ANALOG_1), VR1.2 (S)
RESET: IC5.29 (RESET), J1.5, R9.2
RFMIRQ: IC5.13 (DIGITAL_9(PWM)), J1.7, J4.2
RXD0: IC5.31 (DIGITAL_1(TX)), R12.2
RXD0B: J1.11, R12.1
SCL: D1.3 (AC), IC1.1 (SCL), IC2.6 (SCL), IC5.28 (ANALOG_5), J1.9, R5.1
SDA: D2.3 (AC), IC1.6 (SDA), IC2.1 (SDA), IC5.27 (ANALOG_4), J1.10, R6.1
SPI_MISO: IC5.16 (DIGITAL_12), J1.1, J4.6
SPI_MOSI: IC5.15 (DIGITAL_11(PWM)), J1.4, J4.5
SPI_NNS: IC5.14 (DIGITAL_10(PWM)), J1.8, J4.3, R7.1
SPI_SCLK: IC5.17 (DIGITAL_13(LED)), J1.3, J4.4
TXD0: IC5.30 (DIGITAL_0(RX)), R11.2
TXD0B: J1.12, R11.1
VCC: C1.1, C2.1, C5.1, C6.1, C7.1, C8.1, C9.1, C12.2, C13.2, D1.2 (C), D2.2 (C), D3.2 (C), D5.A, F1.A (1), IC1.5 (V+), IC2.5 (V+), IC5.4 (VCC1), IC5.6 (VCC2), J1.2, J4.1, R2.2, R5.2, R6.2, R7.2, R8.2, R9.1, R13.2, R22.1, U1.18 (VCC_2), U1.19 (VCC_3), U1.20 (VCC), U$2.A, VR1.3 (E)

Notes on the sheet:
IC2
IC1
ON BOM (14/10-2016)

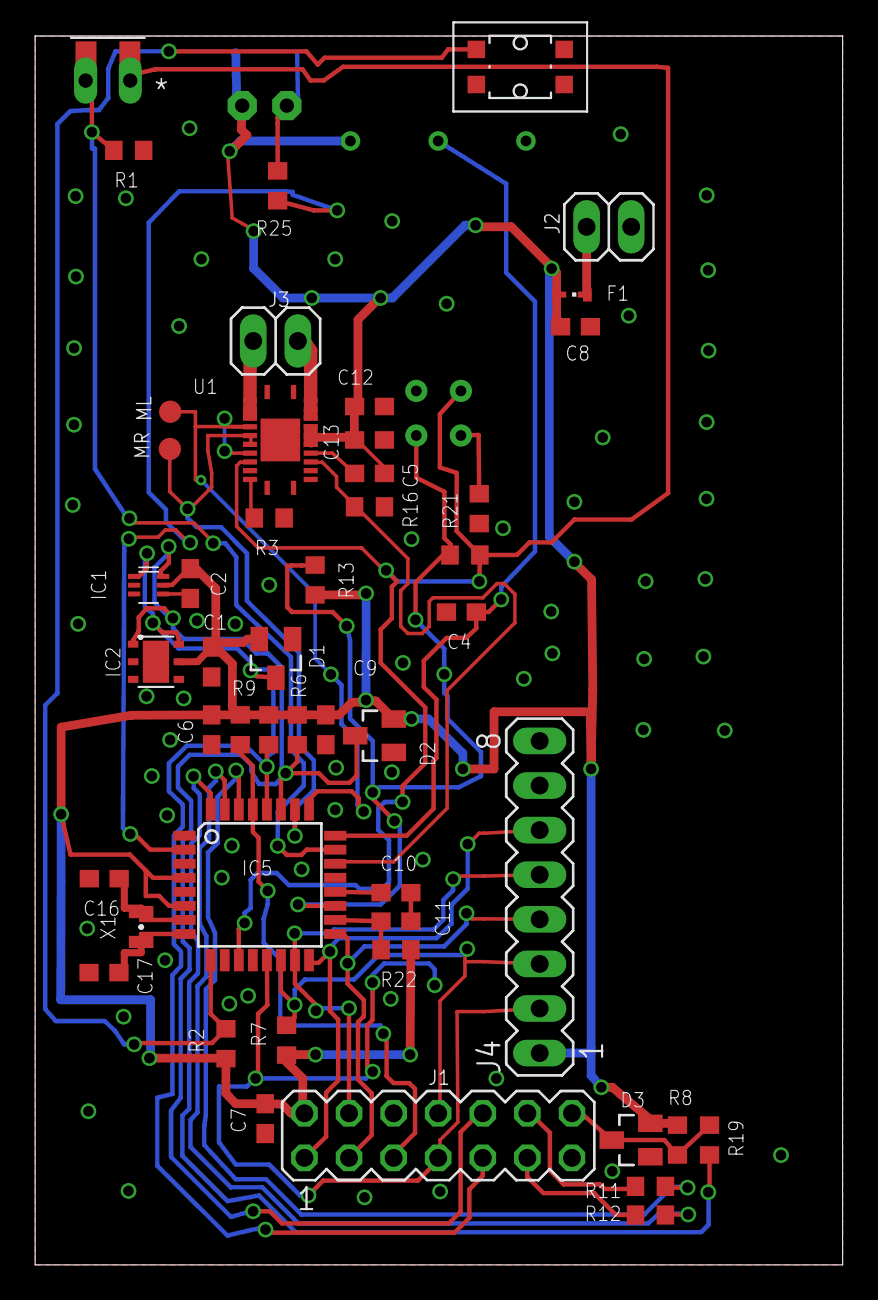
[picture p4: board TRV2_0.brd from above]

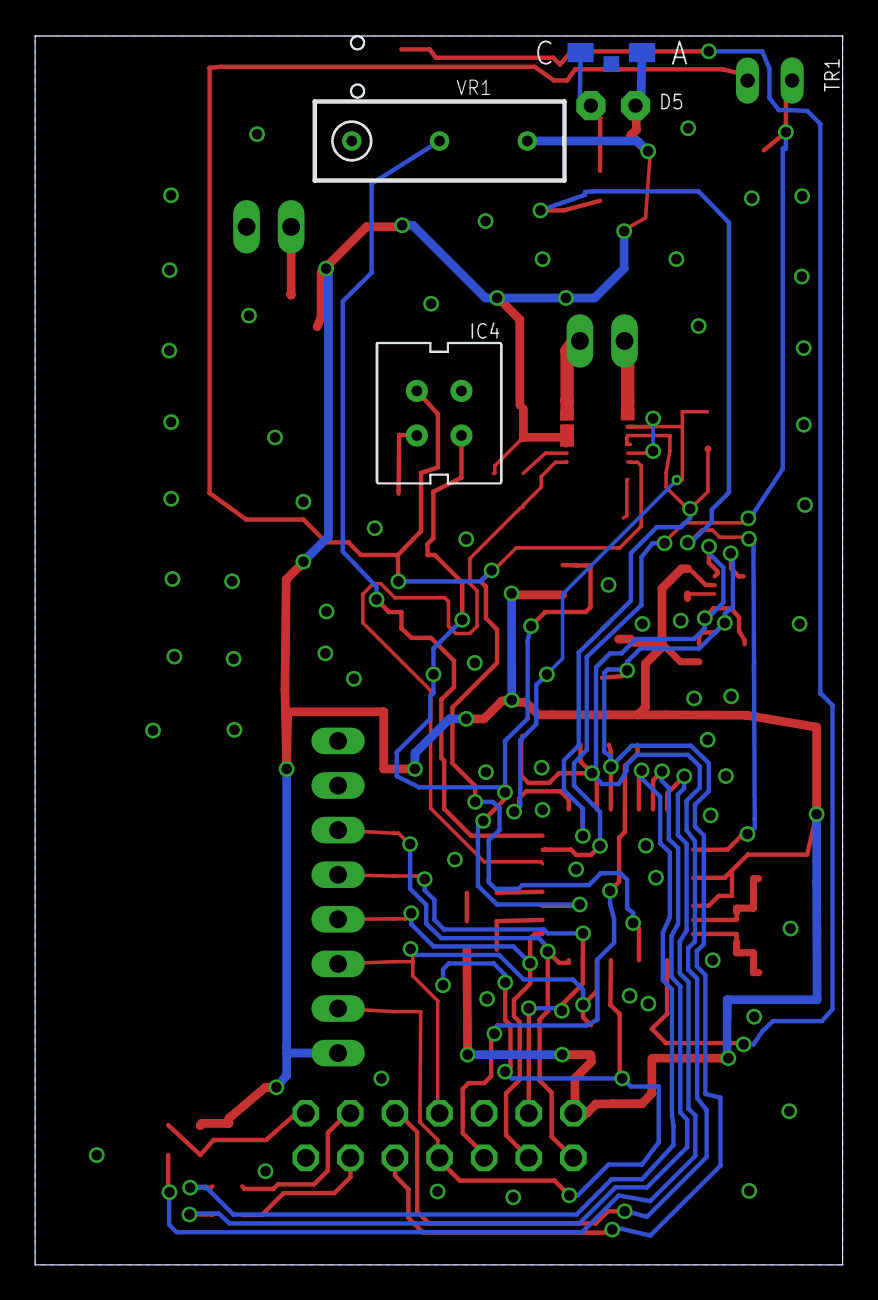
[picture p5: board TRV2_0.brd from below]

Board: 2 copper layers, 46.0 x 70.0 mm, 53 parts (5 on the bottom side), 36 nets.
