opentrv/OpenTRV-TRV1.6/(commit log)

2016-10-03 Create place for PCB.
2016-10-04 Schematic done
    NOTE: INT on light sensor not found anywhere else on schematic.
    NOTE: Comms connector differs from Standard.
    [TRV2_0.sch]
2016-10-04 double checked schematic
    [TRV2_0.sch]
2016-10-04 first draft of board added
    [TRV2_0.brd]
2016-10-04 Componets rotated and locked
    locked as they now point the same way as the one made by enlight
    [TRV2_0.brd, TRV2_0.sch]
2016-10-05 added motor header
    [TRV2_0.brd, TRV2_0.sch]
2016-10-06 cleaned up
    Issues this far
    >>>- We don't want the RFM23B on this model (Damon, do we want to keep
    the footprint?)
    >>>- We want TR1 and D5 to be SMD devices with the 'active' side on the
    top edge of the board.
    >>>-Why does comms connector not use our standard 100%? pin8 was not
    labeled at all and one more had a different name
    [TRV2_0.brd, TRV2_0.sch]
2016-10-07 removed RFM
    8 pin header is just placeholder for now
    [TRV2_0.brd, TRV2_0.sch]
2016-10-10 SMD LED and photo added
    [TRV2_0.brd, TRV2_0.sch]
2016-10-11 png's updated and motordriver placed on board
    [TRV2_0.brd, TRV2_0.sch]
2016-10-12 changes as pr deniz requests
    [TRV2_0.brd, TRV2_0.sch]
2016-10-12 Motor driver conncedted
    [TRV2_0.brd, TRV2_0.sch]
2016-10-12 enlight board tracks added on layer 229 & 230
    [TRV2_0.brd]
2016-10-12 intial "core" tracks layed out
    copy of tracks as per enlight
    [TRV2_0.brd, TRV2_0.sch]
2016-10-13 Before routing tracks
    [TRV2_0.brd, TRV2_0.sch]
2016-10-13 3 wires left
    [TRV2_0.brd]
2016-10-13 2 wires left
    [TRV2_0.brd]
2016-10-13 all wires done - need to do ERC and DRC
    [TRV2_0.brd]
2016-10-13 ERC done - need to add fuse value
    [TRV2_0.sch]
2016-10-14 DRV8850 lbr added and a whole BIG lot of DRC's sorted
    [TRV2_0.brd, TRV2_0.sch]
2016-10-14 near done :-D
    [TRV2_0.brd, TRV2_0.sch]
2016-10-14 before gerbers
    [TRV2_0.brd]
2016-10-14 ready for gerbers
    [TRV2_0.brd, TRV2_0.sch]
2016-10-14 generated gerbers + zip
    [TRV2_0.GBL, TRV2_0.GBO, TRV2_0.GBP, TRV2_0.GBS, TRV2_0.GTL, TRV2_0.GTO, TRV2_0.GTP, TRV2_0.GTS]
2016-10-14 added power to radio module connector
    [TRV2_0.brd, TRV2_0.sch]
2016-10-14 More GND Via's added
    [TRV2_0.brd]
2016-10-14 did not save all
    [TRV2_0.brd]
2016-10-17 Added draft BOM as .ods
    [201610 DRAFT TRV2 BOM.ods]
2016-10-20 better xtal clearance and pot on io_powerup
    [TRV2_0.brd, TRV2_0.sch]
2017-01-03 Added constantly updating test for sensors
2017-01-16 working on motor driver
2017-04-21 TRV2.5 design in KiCAD
    [TRV2p5.kicad_pcb, TRV2p5.sch, trv3_motor.sch, trv3_sensors.sch, trv3_ui.sch]
