opentrv/OpenTRV-TRV1.6/(notices)

Notices in the files:
parts and their libraries:
EAGLE-TACT_SWITCHES-rev16e: Copyright: Würth Elektronik
SparkFun-Aesthetics: Licensing: CC v3.0 Share-Alike You are welcome to use this library for commercial purposes.
